nfikes/AutoNav-Charge_Indicator-KiCad_Pcb/Wireless E-Stop/output/design/README.md

# KiCad Design Review Bundle

Input: `/Users/nathanfikes/Projects/GitHub/AutoNav-Charge_Indicator-KiCad_Pcb/Wireless E-Stop/Wireless E-Stop.kicad_pro`

This folder is generated by `kicad-cruncher design` / `design-review` / `dr`.
It is intended for design review agents that need a machine-readable design
model plus visual context.

## Files

- `Wireless E-Stop_design.json`: KiCad-native design JSON from `kicad-monkey`.
- `design_review_manifest.json`: artifact index for this review bundle.
- `schematics/`: enriched black-and-white schematic SVGs, one file per
  concrete hierarchy instance.
- `pcb/copper_layers/`: enriched PCB SVGs, one file per copper layer.

## Design JSON Relationships

The design JSON schema is `kicad_monkey.design.a0`. It includes project text
variables, schematic hierarchy, components, nets, optional PnP data, and lookup
indexes unless `--no-indexes` was used.

Component and net entries carry SVG link fields where available. Schematic SVG
groups use `data-uuid`, `data-ref`, `data-component`, `data-pin-*`, and net
relationship attributes so an agent can map graphics back to symbols, pins,
ports, sheets, and nets. PCB SVG groups use `data-component`, `data-pad-*`,
`data-net`, `data-layer-*`, `data-hole-*`, and IPC-4761 via metadata when the
source board provides it.

## Schematic SVGs

- `schematics/01_Wireless_E-Stop.svg`: sheet 1/1 `/` instance `/f735cb90-c129-4e62-b97c-0850bd889294`

Repeated hierarchical sheets produce separate SVGs. Use `sheet_path` for the
human hierarchy path and `sheet_instance_path` for the KiCad UUID instance path.
Schematic SVGs use the `kicad_cruncher.design_review.schematic_svg.a0` role theme from
`kicad-monkey`: enriched source-object groups and net metadata are preserved,
while schematic graphics are rendered as black on a white page for review.

## PCB Review SVGs

- No PCB copper-layer SVGs were generated.

PCB review SVGs preserve the enriched `kicad-monkey` metadata and apply this
review theme:

- pads belonging to footprints: black (`#000000`);
- tracks, arcs, vias, and zones/polygons: light gray (`#B8B8B8`);
- board outline / `Edge.Cuts`: black (`#000000`);
- plated drills: blue (`#2563EB`);
- plated slots: cyan (`#0891B2`);
- non-plated drills: red (`#DC2626`);
- non-plated slots: orange (`#F97316`);
- unknown-plating holes: neutral gray (`#6B7280`).

Drill and slot cutouts come from the enriched `kicad-monkey` PCB SVG records.
Applications should use `data-hole-plating` and `data-hole-kind` to distinguish
plated through-hole pads/vias from KiCad `np_thru_hole` mechanical pads. Valid
plating values are `plated`, `non_plated`, and `unknown`. The design-review
theme colors those existing records in place; it does not create a second
drill/slot overlay, add duplicate boolean plating fields, or change the
`kicad-monkey` spelling of `non_plated`.

Draw order is tracks/arcs first, polygons/zones above those, edge cuts, pads,
then the `kicad-monkey` drill/slot records last.
