nfikes/AutoNav-Charge_Indicator-KiCad_Pcb/Programming/Image Analysis/pad_circles_check.png

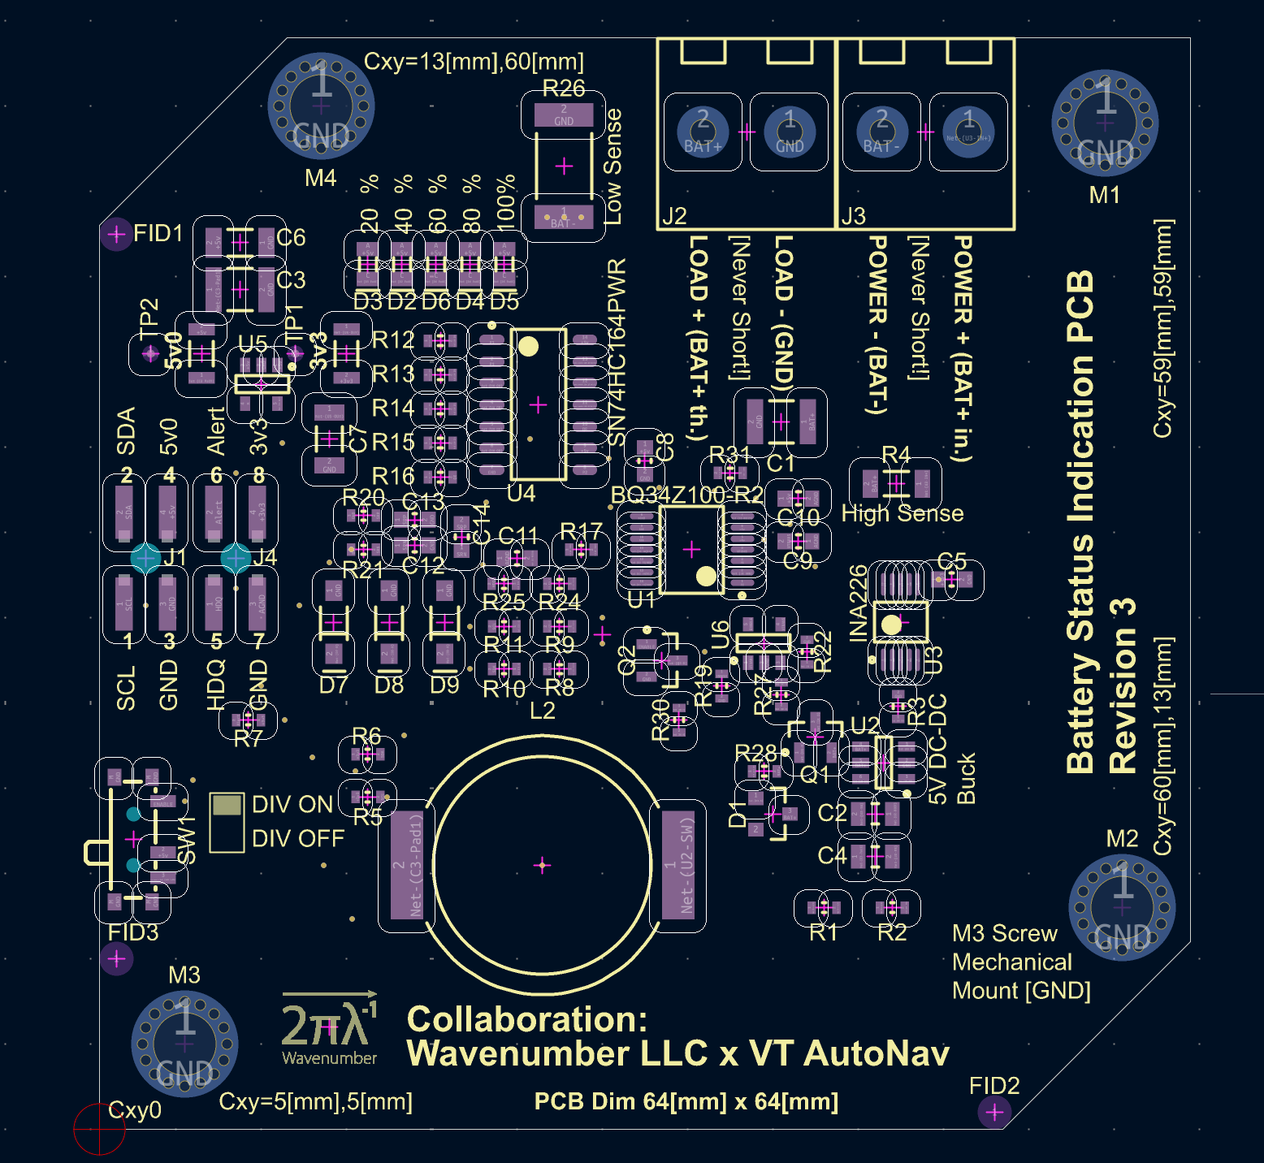
Programming/Image Analysis/pad_circles_check.png
