nfikes/AutoNav-Charge_Indicator-KiCad_Pcb/Charge_Indicator/BOM and Order Sheet/Order_Sheet_REV2.xlsx

 |  |  |  |  |  |  |  |  |  | Orange cells are pre order cells.
PCB To Create | Qty | Unit: (Ea./Pkg./Ft.) | Item Description | MPN | Manufacturer | Supplier | Supplier Identifier | Unit Cost (Including Shipping if Avaliable) | Total | Link to item
5 | 5 | Ea. | 2-layer Bare Rigid Printed circuit board | N/A | JLCPCB | JLCPCB | N/A | $6.33 | $31.65 | Included in the invoice
 | 5 | Ea. | Slide Switch | SSSS811101 | ALPSALPINE | JLCPCB | C109335 | $0.14 | $0.68 | https://jlcpcb.com/partdetail/ALPSALPINE-SSSS811101/C109335
 | 5 | Ea. | 3.3V Low Dropout Regulator | TPS7A2033PDBVR | Texas Instruments | JLCPCB | C2862740 | $0.14 | $0.72 | https://jlcpcb.com/partdetail/TexasInstruments-TPS7A2033PDBVR/C2862740
 | 5 | Ea. | 10kΩ Resistor | ERJ8ENF1002V | PANASONIC | JLCPCB | C193993 | $0.04 | $0.18 | https://jlcpcb.com/partdetail/PANASONIC-ERJ8ENF1002V/C193993
 | 5 | Ea. | 12mΩ Resistor | RL1206FR-070R012L | YAGEO | Digikey | 13-RL1206FR-070R012LTR-ND | $0.45 | $2.25 | https://www.digikey.com/en/products/detail/yageo/RL1206FR-070R012L/3885436
 | 5 | Ea. | 1kΩ Resistor | ERJ3EKF1001V | PANASONIC | JLCPCB | C118155 | $0.01 | $0.03 | https://jlcpcb.com/partdetail/PANASONIC-ERJ3EKF1001V/C118155
 | 25 | Ea. | 470Ω Resistor | ERJ3EKF4700V | PANASONIC | JLCPCB | C169259 | $0.01 | $0.13 | https://jlcpcb.com/partdetail/PANASONIC-ERJ3EKF4700V/C169259
 | 40 | Ea. | 100Ω Resistor | ERJ3EKF1000V | PANASONIC | JLCPCB | C193336 | $0.01 | $0.22 | https://jlcpcb.com/partdetail/PANASONIC-ERJ3EKF1000V/C193336
 | 15 | Ea. | 4.7kΩ Resistor | ERJ3EKF4701V | PANASONIC | JLCPCB | C192166 | $0.0046 | $0.07 | https://jlcpcb.com/partdetail/PANASONIC-ERJ3EKF4701V/C192166
 | 5 | Ea. | 10kΩ Resistor | ERJ3EKF1002V | PANASONIC | JLCPCB | C191124 | $0.01 | $0.03 | https://jlcpcb.com/partdetail/PANASONIC-ERJ3EKF1002V/C191124
 | 5 | Ea. | 200Ω Resistor | ERJ3EKF2000V | PANASONIC | JLCPCB | C403056 | $0.01 | $0.03 | https://jlcpcb.com/partdetail/PANASONIC-ERJ3EKF2000V/C403056
 | 5 | Ea. | 52.3kΩ Resistor | ERJ3EKF5232V | PANASONIC | JLCPCB | C403264 | $0.0048 | $0.02 | https://jlcpcb.com/partdetail/PANASONIC-ERJ3EKF5232V/C403264
 | 0 | Ea. | 0Ω Resistor | SKIP | SKIP | SKIP | SKIP | $0.00 | $0.00 | SKIP
 | 5 | Ea. | 5mΩ Resistor | CSR2512B0R005F | Riedon | JLCPCB | C4257075 | $0.22 | $1.08 | https://jlcpcb.com/partdetail/Riedon-CSR2512B0R005F/C4257075
 | 10 | Ea. | Pin Header | PZ254-2-02-S | HCTL | JLCPCB | C3294460 | $0.04 | $0.43 | https://jlcpcb.com/partdetail/HCTL-PZ254_2_02S/C3294460
 | 10 | Ea. | Yellow LED | LTST-C170KSKT | Lite-On | JLCPCB | C125091 | $0.02 | $0.22 | https://jlcpcb.com/partdetail/LiteOn-LTSTC170KSKT/C125091
 | 5 | Ea. | Red LED | APT2012SURCK | Kingbright | JLCPCB | C5875730 | $0.11 | $0.57 | https://jlcpcb.com/partdetail/Kingbright-APT2012SURCK/C5875730
 | 10 | Ea. | Green LED | APT2012CGCK | Kingbright | JLCPCB | C5875740 | $0.11 | $1.15 | https://jlcpcb.com/partdetail/Kingbright-APT2012CGCK/C5875740
 | 5 | Ea. | High Current Surface Mount Power Inductors | DO5010H-223 | Coilcraft | Coilcraft | DO5010H-223MLD | $2.22 | $11.10 | https://www.coilcraft.com/en-us/products/power/unshielded-inductors/ferrite-drum-surface-mount/do/do5010h/do5010h-223
 | 5 | Ea. | 30V Zener Diode | BZX84B30-7-F | Diodes Incorporated | JLCPCB | C460806 | $0.04 | $0.19 | https://jlcpcb.com/partdetail/DiodesIncorporated-BZX84B30_7F/C460806
 | 15 | Ea. | 5.6V Zener Diode | BZT52C5V6-7-F | Diodes Incorporated | JLCPCB | C397930 | $0.03 | $0.44 | https://jlcpcb.com/partdetail/DiodesIncorporated-BZT52C5V6_7F/C397930
 | 5 | Ea. | 22µF Capacitor | GCJ32ER71C226KE01L | Murata Electronics | JLCPCB | C417134 | $0.63 | $3.13 | https://jlcpcb.com/partdetail/410292-GCJ32ER71C226KE01L/C417134
 | 5 | Ea. | 10µF Capacitor | GCM32EC71H106KA03K | Murata Electronics | JLCPCB | C2180054 | $0.28 | $1.39 | https://jlcpcb.com/partdetail/2272121-GCM32EC71H106KA03K/C2180054
 | 10 | Ea. | 10µF Capacitor | CGA5L1X7R1V106K160AC | TDK | JLCPCB | C42546209 | $0.16 | $1.58 | https://jlcpcb.com/partdetail/TDK-CGA5L1X7R1V106K160AC/C42546209
 | 5 | Ea. | 0.47µF Capacitor | GCJ21BR71H474KA12L | Murata Electronics | JLCPCB | C441756 | $0.04 | $0.21 | https://jlcpcb.com/partdetail/442080-GCJ21BR71H474KA12L/C441756
 | 5 | Ea. | 330pF Capacitor | GCM21A7U2E331JX01D | Murata Electronics | JLCPCB | C393691 | $0.04 | $0.18 | https://jlcpcb.com/partdetail/371982-GCM21A7U2E331JX01D/C393691
 | 5 | Ea. | 1µF Capacitor | GCJ188R71E105KA01D | Murata Electronics | JLCPCB | C908553 | $0.05 | $0.24 | https://jlcpcb.com/partdetail/975294-GCJ188R71E105KA01D/C908553
 | 35 | Ea. | 0.1µF Capacitor | GCJ188R71C104KA01D | Murata Electronics | JLCPCB | C710619 | $0.03 | $1.19 | https://jlcpcb.com/partdetail/748891-GCJ188R71C104KA01D/C710619
 | 10 | Ea. | Terminal Block | 1711725 | Phoenix Contact | Digikey | 277-1027-ND | $1.69 | $16.88 | https://www.digikey.com/en/products/detail/phoenix-contact/1711725/260395
 | 5 | Ea. | Parallel Shift Register | SN74HC164PWR | Texas Instruments | JLCPCB | C406867 | $0.15 | $0.75 | https://jlcpcb.com/partdetail/TexasInstruments-SN74HC164PWR/C406867
 | 5 | Ea. | DC-DC Converter | SGM61410XN6G/TR | SGMICRO | JLCPCB | C699689 | $1.41 | $7.07 | https://jlcpcb.com/partdetail/SGMICRO-SGM61410XN6GTR/C699689
 | 5 | Ea. | Current Sense Amplifier | INA226AIDGSR | Texas Instruments | JLCPCB | C49851 | $0.63 | $3.17 | https://jlcpcb.com/partdetail/TexasInstruments-INA226AIDGSR/C49851
 | 5 | Ea. | Multichemistry Impedance Track stand-alone Fuel Gauge | BQ34Z100PWR-R2 | Texas Instruments | JLCPCB | C7220642 | $4.37 | $21.83 | https://jlcpcb.com/partdetail/TexasInstruments-BQ34Z100PWRR2/C7220642
4 | 4 | Ea. | P-Channel Mosfet | BSS84-7-F | Diodes Incorporated | JLCPCB | C85202 | $0.03 | $0.13
 | 4 | Ea. | N-Channel Mosfet | 2N7002P,215 | Nexperia | JLCPCB | C81488 | $0.23 | $0.93
 | 4 | Ea. | Operational Amplifier | TLV271CW5-7 | Diodes Incorporated | JLCPCB | C150498 | $0.17 | $0.67
 | 4 | Ea. | 16V Zener Diode | BZX84B16-7-F | Diodes Incorporated | JLCPCB | C5244749 | $0.03 | $0.10
 | 8 | Ea. | 34.8kΩ Resistor | ERJ-3EKF3482V | PANASONIC | JLCPCB | C403173 | $0.01 | $0.04
 | 8 | Ea. | 200kΩ Resistor | ERJ-3EKF2003V | PANASONIC | JLCPCB | C118142 | $0.01 | $0.04
 | 4 | Ea. | 1MΩ Resistor | ERJ-3EKF1004V | PANASONIC | JLCPCB | C193390 | $0.0049 | $0.02
5 | 5 | Ea. | 0.005ΩSurge Resistor | ‎WSL25125L000FEA‎ | Vishay Dale | Digikey | WSLG-.005CT-ND | $1.73 | $8.65 | https://www.digikey.com/en/products/detail/vishay-dale/WSL25125L000FEA/712555
 | 5 | Ea. | 0.01ΩSurge Resistor | WSL1206R0100JEA‎ | Vishay Dale | Digikey | 541-WSL1206R0100JEACT-ND | $1.27 | $6.35 | https://www.digikey.com/en/products/detail/vishay-dale/WSL1206R0100JEA/9752083
 | 5 | Ea. | 10kΩThermistor | ‎NCP18XH103D03RB | Murata Electronics | Digikey | 490-11813-1-ND | $0.28 | $1.39 | https://www.digikey.com/en/products/detail/murata-electronics/NCP18XH103D03RB/5773685
 |  |  |  |  |  |  | Sub-Total |  | $127.10
 | Name: | Nathan Fikes |  |  |  |  | Extra Costs
 | Company: | Wavenumber LLC |  |  |  |  | Grand Total |  | $127.10
 |  |  |  |  |  |  | Cost per entire Assembled PCB: |  | $25.42
 |  |  |  |  |  |  | (Tariffs, Import Duties, Shipping, Etc, Change Suppliers)
 |  |  |  |  |  |  | Actual Costs Breakdown: (REV1)
 |  |  |  |  |  |  | Digikey | $116.94
 |  |  |  |  |  |  | Coilcraft | $22.43
 |  |  |  |  |  |  | LCSC | $18.69
 |  |  |  |  |  |  |  | $158.06
 |  |  |  |  |  |  | Actual Costs Breakdown: (REV2)
 |  |  |  |  |  |  | JLCPCB | $5.24
 |  |  |  |  |  |  | LCSC | $15.76
 |  |  |  |  |  |  |  | $21.00
