nfikes/AutoNav-Charge_Indicator-KiCad_Pcb/Charge_Indicator/BOM and Order Sheet/Cost Tracking Redact/Cost_Tracking_Sheet.xlsx

Order/Invoice # | Supplier | Total Cost of the Order (Including Taxes, Shipping, Etc)
CO 3072306 | CoilCraft | $22.43
118559797 | DigiKey | $116.94
119203286 | DigiKey | $11.23
8055077A2025112413035130 | JLCPCB | $31.65
8055077A2026010509562232 | JLCPCB | $5.24
WM2511300070 | LCSC | $18.69
WM2601050125 | LCSC | $15.76
8055077A2026021913056103 | JLCPCB | $5.23
98147822 | DigiKey | $8.08
 | Total: | $235.25
