nfikes/AutoNav-Charge_Indicator-KiCad_Pcb/Charge_Indicator/BOM and Order Sheet/Cost Tracking Redact/JLCPCB_Invoice REV1.pdf

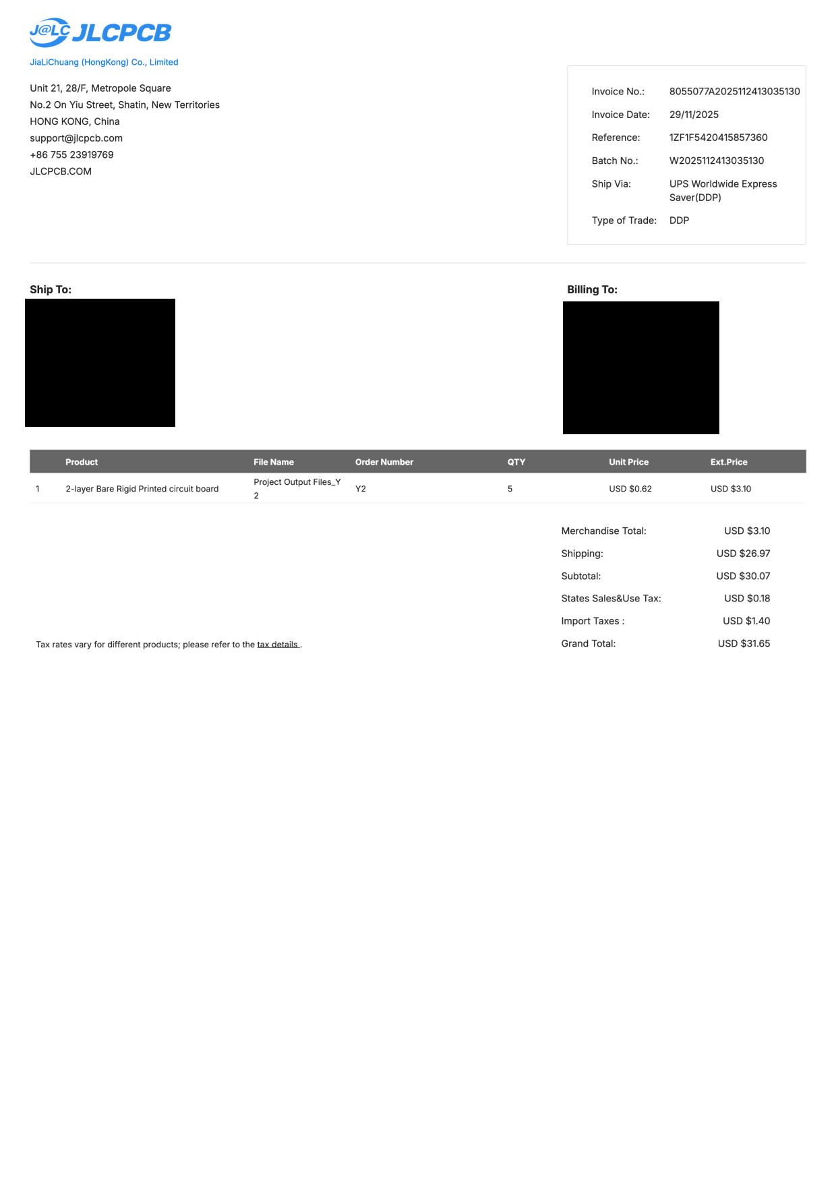
[picture p2: page 1]
