nfikes/AutoNav-Charge_Indicator-KiCad_Pcb/Charge_Indicator/BOM and Order Sheet/Cost Tracking Redact/JLCPCB_Invoice REV2.pdf

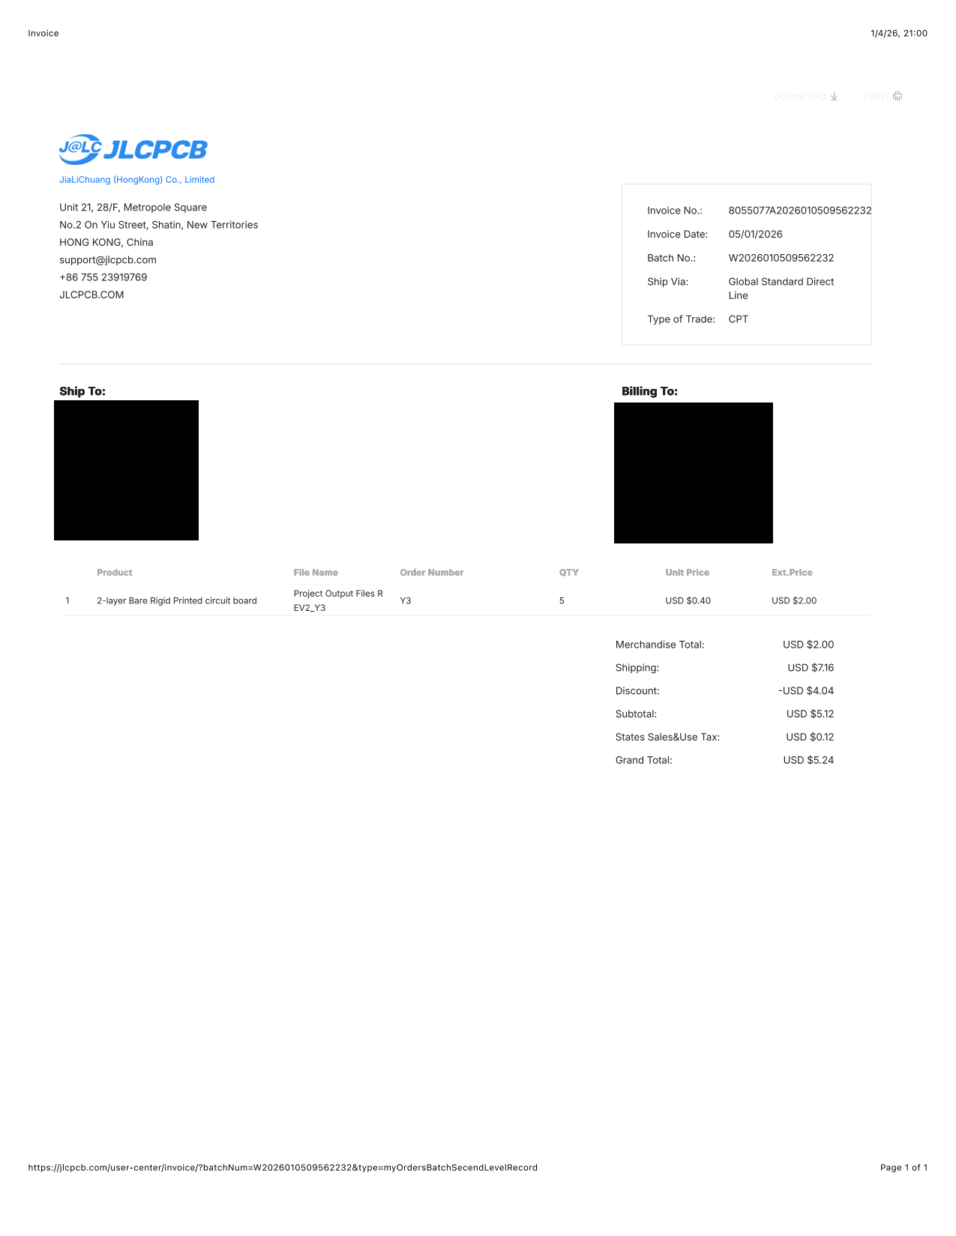
[picture p3: page 1]
