nfikes/AutoNav-Charge_Indicator-KiCad_Pcb/Charge_Indicator/VoltageCurrentTest.xlsx

 |  |  |  |  | 105000 | ESR
Voltage [V] | Current [A] | 5v0 line lowest | 3v3 line lowest | Calculated Power Draw [W]
7.00 | 0.029 | 5.040 | 3.200 | 0.20300
8.00 | 0.026 | 4.960 | 3.240 | 0.20800
9.00 | 0.024 | 4.960 | 3.200 | 0.21600
10.00 | 0.021 | 4.960 | 3.200 | 0.21000
11.00 | 0.020 | 4.960 | 3.240 | 0.22000
12.00 | 0.018 | 4.960 | 3.200 | 0.21600
13.00 | 0.018 | 4.920 | 3.200 | 0.23400
14.00 | 0.018 | 4.960 | 3.160 | 0.25200
15.00 | 0.015 | 4.880 | 3.200 | 0.22500
16.00 | 0.015 | 4.840 | 3.120 | 0.24000
17.00 | 0.013 | 4.840 | 3.240 | 0.22100
18.00 | 0.012 | 4.840 | 3.200 | 0.21600
19.00 | 0.011 | 4.800 | 3.240 | 0.20900
20.00 | 0.011 | 4.800 | 3.200 | 0.22000
21.00 | 0.009 | 4.760 | 3.200 | 0.18900
22.00 | 0.009 | 4.720 | 3.200 | 0.19800
23.00 | 0.009 | 4.680 | 3.240 | 0.20700
24.00 | 0.009 | 4.640 | 3.200 | 0.21600
25.00 | 0.009 | 4.680 | 3.200 | 0.22500
26.00 | 0.007 | 4.680 | 3.240 | 0.18200
27.00 | 0.007 | 4.680 | 3.200 | 0.18900
28.00 | 0.007 | 4.640 | 3.200 | 0.19600
29.00 | 0.006 | 4.680 | 3.240 | 0.17400
30.00 | 0.006 | 4.680 | 3.200 | 0.18000
