nfikes/AutoNav-Charge_Indicator-KiCad_Pcb/Programming/empirical_results/ina226_20260427_150746/ina226_20260427_150746.csv

ROS2_Clock | Topic_Name | Data_Keys | Value_0 | Value_1 | Value_2 | Value_3
3462028026 | /electrical/voltage | voltage_V | 26.3925
3462028026 | /electrical/current | current_A | 0.96250
3462028026 | /electrical/power | power_W | 25.219
3462028026 | /electrical/soc | soc_pct | 67.7
3568830966 | /electrical/voltage | voltage_V | 26.4112
3568830966 | /electrical/current | current_A | 0.94425
3568830966 | /electrical/power | power_W | 24.944
3568830966 | /electrical/soc | soc_pct | 68.4
3675338029 | /electrical/voltage | voltage_V | 26.3800
3675338029 | /electrical/current | current_A | 0.94100
3675338029 | /electrical/power | power_W | 24.738
3675338029 | /electrical/soc | soc_pct | 67.2
3781199932 | /electrical/voltage | voltage_V | 26.4112
3781199932 | /electrical/current | current_A | 0.95100
3781199932 | /electrical/power | power_W | 24.719
3781199932 | /electrical/soc | soc_pct | 68.4
3888548851 | /electrical/voltage | voltage_V | 26.3800
3888548851 | /electrical/current | current_A | 0.96575
3888548851 | /electrical/power | power_W | 25.181
3888548851 | /electrical/soc | soc_pct | 67.2
3995712995 | /electrical/voltage | voltage_V | 26.3738
3995712995 | /electrical/current | current_A | 0.95825
3995712995 | /electrical/power | power_W | 25.263
3995712995 | /electrical/soc | soc_pct | 67.0
4102012872 | /electrical/voltage | voltage_V | 26.3837
4102012872 | /electrical/current | current_A | 0.95450
4102012872 | /electrical/power | power_W | 25.394
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
33762746810 | /electrical/current | current_A | 1.21100
33762746810 | /electrical/power | power_W | 32.000
33762746810 | /electrical/soc | soc_pct | 66.2
33869801998 | /electrical/voltage | voltage_V | 26.3338
33869801998 | /electrical/current | current_A | 1.21225
33869801998 | /electrical/power | power_W | 32.094
33869801998 | /electrical/soc | soc_pct | 65.5
33977063894 | /electrical/voltage | voltage_V | 26.3650
33977063894 | /electrical/current | current_A | 1.20850
33977063894 | /electrical/power | power_W | 32.212
33977063894 | /electrical/soc | soc_pct | 66.7
34084203004 | /electrical/voltage | voltage_V | 26.3562
34084203004 | /electrical/current | current_A | 1.21100
34084203004 | /electrical/power | power_W | 32.331
34084203004 | /electrical/soc | soc_pct | 66.3
34191317081 | /electrical/voltage | voltage_V | 26.3463
34191317081 | /electrical/current | current_A | 1.21600
34191317081 | /electrical/power | power_W | 32.019
34191317081 | /electrical/soc | soc_pct | 66.0
