nfikes/AutoNav-Charge_Indicator-KiCad_Pcb/Programming/empirical_results/discharge_log_20260401_175518.csv

elapsed_s | timestamp | bus_voltage_mV | cell_voltage_mV | current_mA | shunt_uV | power_mW | ah_discharged | soc_pct
0.0 | 2026-04-01T17:55:18.595383 | 26558 | 3319.8 | -1159.8 | 13922.5 | 30.8 | 0.0000 | 100.00
10.0 | 2026-04-01T17:55:28.604870 | 26542 | 3317.8 | -1169.5 | 14040.0 | 31.0 | 0.0033 | 99.99
20.0 | 2026-04-01T17:55:38.614025 | 26527 | 3315.9 | -1167.8 | 14017.5 | 31.0 | 0.0065 | 99.97
30.0 | 2026-04-01T17:55:48.627916 | 26505 | 3313.1 | -1185.0 | 14157.5 | 31.3 | 0.0098 | 99.96
40.0 | 2026-04-01T17:55:58.635081 | 26473 | 3309.1 | -1236.0 | 14837.5 | 32.8 | 0.0132 | 99.95
50.0 | 2026-04-01T17:56:08.648922 | 26478 | 3309.8 | -1174.0 | 14092.5 | 31.1 | 0.0165 | 99.93
60.1 | 2026-04-01T17:56:18.656302 | 26463 | 3307.9 | -1172.5 | 14075.0 | 31.0 | 0.0198 | 99.92
70.1 | 2026-04-01T17:56:28.661517 | 26451 | 3306.4 | -1171.8 | 14067.5 | 31.0 | 0.0230 | 99.91
80.1 | 2026-04-01T17:56:38.667319 | 26446 | 3305.8 | -1169.3 | 14035.0 | 30.9 | 0.0263 | 99.89
90.1 | 2026-04-01T17:56:48.675973 | 26426 | 3303.2 | -1172.5 | 14075.0 | 31.0 | 0.0295 | 99.88
100.1 | 2026-04-01T17:56:58.687417 | 26412 | 3301.5 | -1182.0 | 14190.0 | 31.2 | 0.0328 | 99.87
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
