nfikes/AutoNav-Charge_Indicator-KiCad_Pcb/Programming/empirical_results/voltage_vs_soc.png

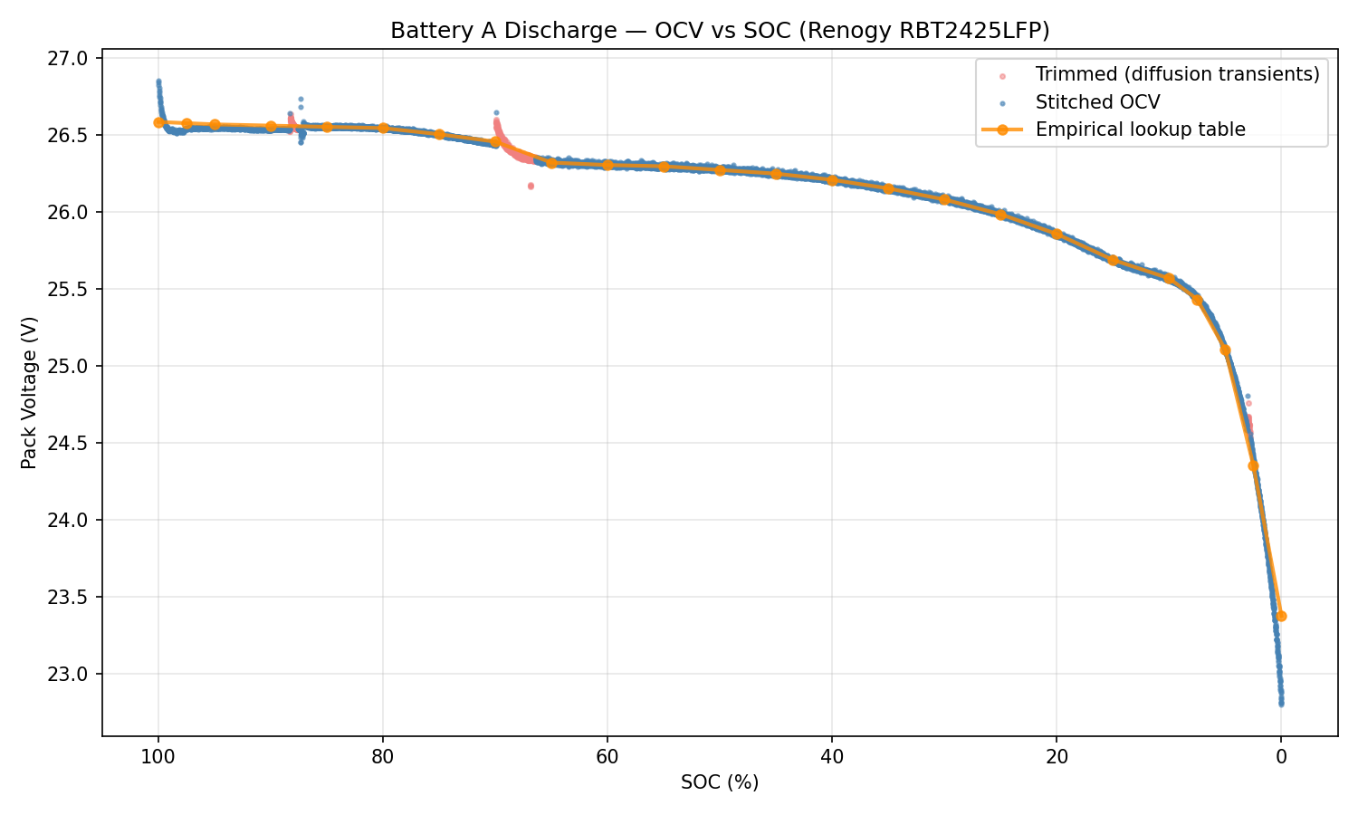
Programming/empirical_results/voltage_vs_soc.png
