nfikes/AutoNav-Charge_Indicator-KiCad_Pcb/Programming/Image Analysis/R3_metal_shaving_risk_analysis.png

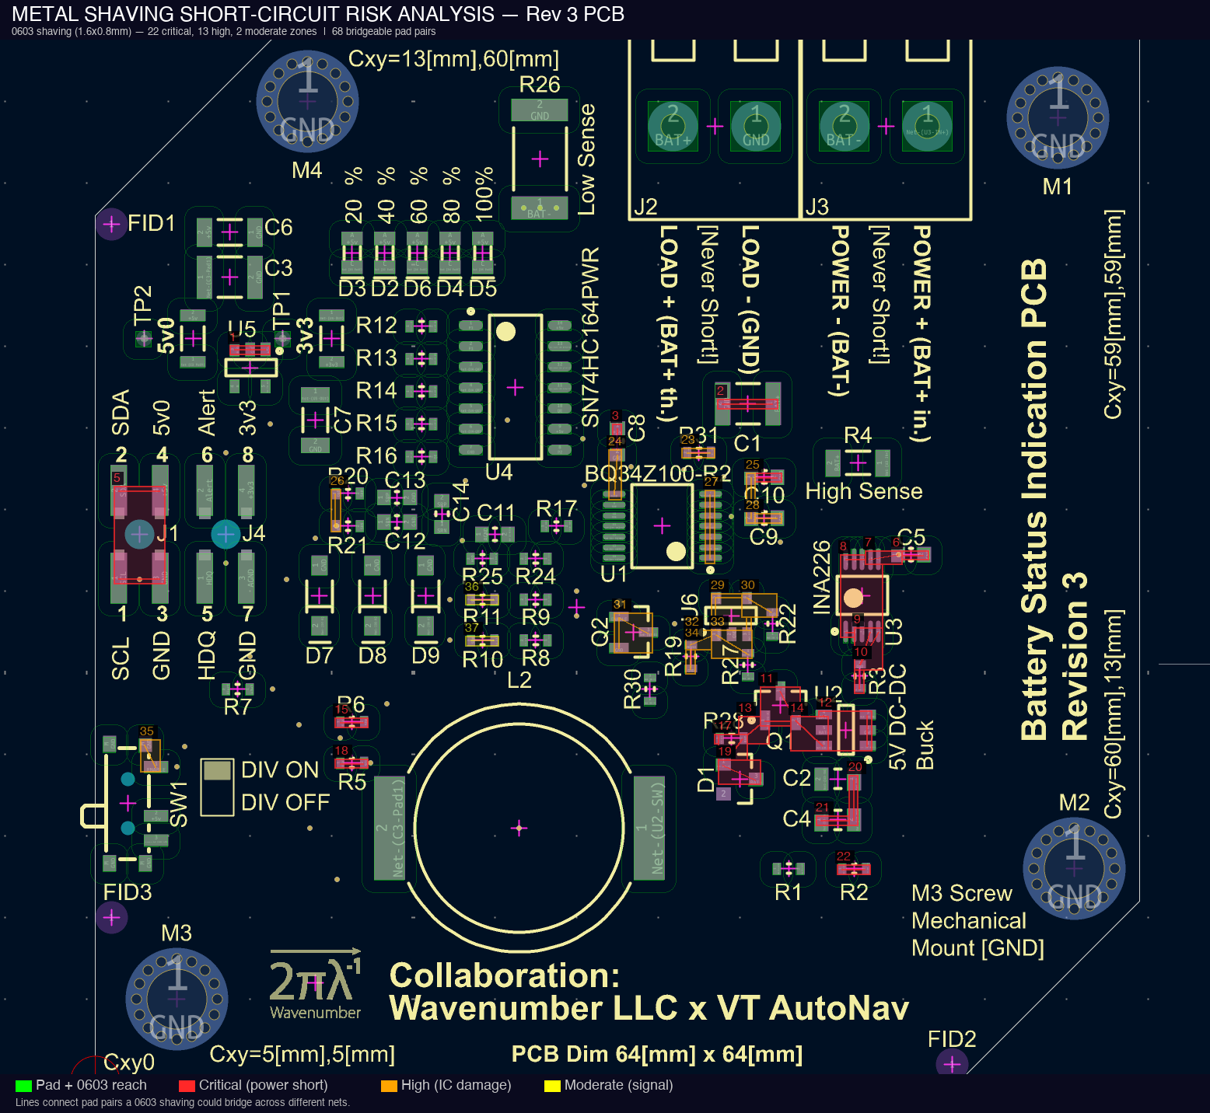
Programming/Image Analysis/R3_metal_shaving_risk_analysis.png
