nfikes/AutoNav-Charge_Indicator-KiCad_Pcb/(commit log)

2025-11-04 Charge Indicator Board Schematic Layout Preliminary
    Adding KiCad PCB project with schematic for working circuit of a Battery Level indicator specifically designed for the RBT2425LFP Battery.
    [Charge_Indicator.kicad_pcb, Charge_Indicator.kicad_sch]
2025-11-04 Add battery level indication PCB details to README
    Added details about the battery level indication PCB, including its purpose and desired functionality.
2025-11-04 Adding some more text to the schematic
    [Charge_Indicator.kicad_pcb, Charge_Indicator.kicad_sch]
2025-11-04 Adding pull ups, reversing logic, adding simulation validation image
    [Charge_Indicator.kicad_sch]
2025-11-05 Adding KiCad generated symbols for SMT components
    Summary of changes:
    - Adding in the kicad_mod and kicad_sym of each of the components.
    - (might be errors with how these libraries are linked up from the local dir)
    - Fixed a wrong resistor in the schematic.
    - Moved around graphics.
    [Charge_Indicator.kicad_sch]
2025-11-05 Adding the Datasheets for the battery
    Useful for determining the load at the PCB terminals.
2025-11-07 Using TI chips for power detection putting everything together.
    [Charge_Indicator.kicad_sch]
2025-11-11 Adding Zero Ohms and Test Points on 5 and 3.3 points
    Summary of Changes:
    - On the buck output is a test point and zero ohm to ensure there is 5V constant.
    - On the regulator output is a test point and zero ohm to ensure there is 3.3V constant.
    [Charge_Indicator.kicad_sch]
2025-11-11 Many changes to the PCB schematic and PCB layout.
    - Using new added chips to wn_pcb branch to connect up into KiCad automatically.
    - Added another PZ254-2-02-S Dupont connection port for the 3v3 line, Alert pin, and HDQ highspeed data acquisition pin.
    - Cleaned up the schematic a bit to make it less confusing.
    - Added 0 Ohm resistors in front of both the buck and regulator so that 3v3 and 5v0 can be checked before real testing.
    - EN pin of the SGM61410XN6G_TR is tied to VIN like stated in the datasheet.
    - Test points added for the 3v3 and 5v0 outputs of both regulator and buck respectively.
    - Fiducials and M3 mechanical holes added.
    - Standardized the size of the PCB to 6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
    [Charge_Indicator.kicad_sch]
2025-11-11 Revise README for Charge Indicator PCB enhancements
    Updated the README to reflect enhancements in the Charge Indicator PCB design, including improved accuracy and additional features.
2025-11-13 Linking up local libraries
    Linking up the symbols and footprints using local libraries for this project.
    [Charge_Indicator.kicad_sch]
2025-11-14 WIP routing
    [Charge_Indicator.kicad_sch]
2025-11-15 Finished routing, might need some changes
    [Charge_Indicator.kicad_sch]
2025-11-22 SW1 Wiring - fix
    - Pin 2 of the switch is now connected to R17.
    - M on the switch is now on Ground.
    - Re-routed on PCB side, now ground polygons span entire PCB to encompass switch grounds.
    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
    [Charge_Indicator.kicad_sch]
2025-11-22 Global Label vs Power Symbol vs NetLabel fix
    - Global labels are now Net Labels.
    - Power rails now have their own power symbol.
    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
    [Charge_Indicator.kicad_sch]
2025-11-22 Move output caps fix
    - 5v0 and 3v3 lines now have their decoupling capacitors next to the test points before the 0 Ohm resistors.
    - Reroute to carry the change to the PCB.
    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
    [Charge_Indicator.kicad_sch]
2025-11-22 Sch Style / Intent fix
    - Major overhaul to how the Schematic side is presented. Now the Sch side is in blocks.
    - Some symbols were updated to create more space and ease of viewing.
    - New lower side current sense resistor at 0.005 Ohms at 2.5 W.
    - New PCB silkscreen Layer items.
    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
    [Charge_Indicator.kicad_sch]
2025-11-22 Fix small little trace visual inconsistency on C5.
    [Charge_Indicator.kicad_sch]
2025-11-24 Fixing errors in the PCB related to the DRC
    [Charge_Indicator-B_Cu.gbr, Charge_Indicator-B_Mask.gbr, Charge_Indicator-B_Paste.gbr, Charge_Indicator-B_Silkscreen.gbr, Charge_Indicator-Edge_Cuts.gbr, Charge_Indicator-F_Cu.gbr, Charge_Indicator-F_Mask.gbr, Charge_Indicator-F_Paste.gbr]
2025-11-24 Switching around the Silkscreen layer text
    [Charge_Indicator-B_Cu.gbr, Charge_Indicator-B_Mask.gbr, Charge_Indicator-B_Paste.gbr, Charge_Indicator-B_Silkscreen.gbr, Charge_Indicator-Edge_Cuts.gbr, Charge_Indicator-F_Cu.gbr, Charge_Indicator-F_Mask.gbr, Charge_Indicator-F_Paste.gbr]
2025-11-24 swapped U5 for SOT23-5 variant
    [Charge_Indicator.kicad_sch]
2025-11-24 Using new package size for the regulator and getting PCB ready
    [Charge_Indicator-B_Cu.gbr, Charge_Indicator-B_Mask.gbr, Charge_Indicator-B_Paste.gbr, Charge_Indicator-B_Silkscreen.gbr, Charge_Indicator-Edge_Cuts.gbr, Charge_Indicator-F_Cu.gbr, Charge_Indicator-F_Mask.gbr, Charge_Indicator-F_Paste.gbr]
2025-11-29 Including a couple raw BOM sheets.
    [Charge_Indicator_BOM.csv]
2025-11-29 Including Order Sheet.
    [Charge_Indicator_BOM.csv, Order_Sheet.xlsx]
2025-11-29 Add images to README for PCB and schematic
    Added images of the PCB, routing, and schematic.
2025-11-29 Update README with images section
    Added images section with physical PCB, routing, and schematic.
2025-12-01 Updating the order sheet to include real costs.
    [Order_Sheet.xlsx]
2025-12-28 Slight changes to schematic
    [Charge_Indicator.kicad_sch, Order_Sheet.xlsx]
2025-12-29 Making changes
    [Charge_Indicator.kicad_sch]
2026-01-05 DRC checks and finishing touches
    [Charge_Indicator.kicad_sch]
2026-01-15 Changes and Exporting fab files
    [Charge_Indicator-B_Cu.gbr, Charge_Indicator-B_Mask.gbr, Charge_Indicator-B_Paste.gbr, Charge_Indicator-B_Silkscreen.gbr, Charge_Indicator-Edge_Cuts.gbr, Charge_Indicator-F_Cu.gbr, Charge_Indicator-F_Mask.gbr, Charge_Indicator-F_Paste.gbr]
2026-02-03 Invoices and Budget tracking documents
    [Cost_Tracking_Sheet.xlsx, VoltageCurrentTest.xlsx]
2026-02-03 Adjust invoices
    [Cost_Tracking_Sheet.xlsx]
2026-02-06 Aardvark I2C quick diagnostics
2026-02-10 Some updates to the diagnostics program and the order sheet.
    [Order_Sheet_REV2.xlsx]
2026-02-19 Add BQ34Z100-R2 initial programming procedure to README
    Documents the safe board programming sequence: SW1 off to protect
    the ADC from VOLTSEL=1, clear VOLTSEL, SW1 on, then program battery
    parameters and chemistry profile. Includes scripts reference table.
2026-02-19 Changes to the PCB for REV 3
    [Charge_Indicator.kicad_sch]
2026-02-19 Fabrication files for REV3
    [Charge_Indicator-B_Cu.gbr, Charge_Indicator-B_Mask.gbr, Charge_Indicator-B_Paste.gbr, Charge_Indicator-B_Silkscreen.gbr, Charge_Indicator-Edge_Cuts.gbr, Charge_Indicator-F_Cu.gbr, Charge_Indicator-F_Mask.gbr, Charge_Indicator-F_Paste.gbr]
2026-02-19 Fixing Net issue
    [Charge_Indicator-B_Cu.gbr, Charge_Indicator-B_Mask.gbr, Charge_Indicator-B_Paste.gbr, Charge_Indicator-B_Silkscreen.gbr, Charge_Indicator-Edge_Cuts.gbr, Charge_Indicator-F_Cu.gbr, Charge_Indicator-F_Mask.gbr, Charge_Indicator-F_Paste.gbr]
2026-03-20 Changing direction to modifying the divider network.
    [ina226_20260319_214850.csv]
2026-03-20 Swapping out resistors at the divider to protect the BQ chip
    [Charge_Indicator.kicad_sch]
2026-03-20 Including drop in components for Rev3
    [Cost_Tracking_Sheet.xlsx]
2026-04-01 BQ debugging and INA226 temp solution for coulomb counting
    [Charge_Indicator.kicad_sch]
2026-04-03 SOC graph collecting
    [discharge_log_20260401_175518.csv]
2026-04-04 Finishin up discharge data capture for coulomb counting
    [discharge_log_20260401_175518.csv]
2026-04-05 Formatting for a report
    [Charge_Indicator.kicad_sch]
2026-04-27 New research, updates to the GUI systems etc.
    [ina226_20260427_145951.csv, ina226_20260427_150119.csv, ina226_20260427_150258.csv, ina226_20260427_150746.csv]
2026-04-28 New monitor to get the SOC charge left time.
2026-05-24 Giving the Wireless E-Stop schematic a home for now.
    [Wireless E-Stop.kicad_pcb, Wireless E-Stop.kicad_sch]
2026-05-24 Moving wireless E-Stop stuff to the base folder.
    [Wireless E-Stop.kicad_pcb, Wireless E-Stop.kicad_sch]
2026-05-25 Starting the SBUS Inverter schematic.
    [SBUS Inverter.kicad_pcb, SBUS Inverter.kicad_sch]
2026-05-25 Finishing up the SBUS inverter.
    [SBUS Inverter.kicad_sch]
2026-05-25 Improving the circuit.
    [SBUS Inverter.kicad_sch]
2026-06-03 Updated things.
    [Wireless E-Stop.kicad_sch]
2026-06-03 Add hardware recommendations for next team
    Add MESSAGE_FOR_NEXT_TEAM.md documenting hardware lessons from the 2025–2026 season. The file lists actionable recommendations for the Charge Indicator PCB: DIP switches for I²C addressing, a 10 A steady-state Kelvin shunt, solid-state SMT e-fuses, wider power traces/copper pours, corrected BQ34Z100-R2 reference circuitry, and an external pack thermistor (plus a mandatory protective enclosure). Includes rationale and specific implementation notes to prevent failures seen in earlier revisions.
2026-06-21 Ignore KiCad fp-info-cache; untrack the committed copy
